berndporr/zetabot/hardware/cameraholder/README.md

# Camera holder

This is for a single camera glued on the LIDAR enclosure in the
middle of the robot.

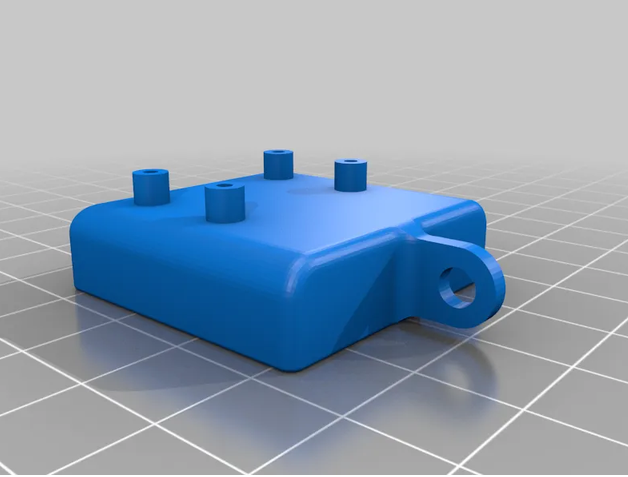
[picture p2: hardware/cameraholder/3dpic.png]


## Credit

https://www.printables.com/model/262546-pi-camera-wall-mount/files

https://www.printables.com/@Magnesium117_343395

License

Creative Commons License This work is licensed under a
Creative Commons (4.0 International License)
Attribution
