berndporr/zetabot/hardware/bom.pdf

ZetaBot

Id Designator | Footprint | Quantity
2 C1 | CP_Radial_D12.5mm_P5.00mm | 1
3 C2, C3, C4, C5, C6 C_Disc_D3.0mm_W2.0mm_P2.50mm | 5
4 D1 | LED_D5.0mm_Clear | 1
5 F1 | Fuseholder_Cylinder-5x20mm_Schurter_0031_8201_Horizontal_Open | 1
6 J1 | USB_C | 1
7 J2 | PinHeader_1x05_P2.54mm_Vertical | 1
8 J3 | PinHeader_1x03_P2.54mm_Vertical | 1
9 J4 | PinHeader_1x03_P2.54mm_Vertical | 1
10 R1 | R_Axial_DIN0207_L6.3mm_D2.5mm_P10.16mm_Horizontal | 1
11 SW1 | TE_4-1825136-5 | 1
12 U1 | RPLIDAR C1 | 1
13 U1 | RPI5 | 1
14 U2 | BUCK_CONV | 1
15 | Servo | 2
16 | Ball castor with 2-hole fastening | 1
17

Designation | Supplier and ref
2200uF/Electr | any
1uF/Tantalum | any
LED | any
Fuse | any
USB C PD Modulle
Conn_01x05 | any
MOTOR_L | any
MOTOR_R | any
330R | any
SW_SPDT | any
RPLIDAR C1
RPI5 | Raspberry
Buck Converter
Parallax Cont Rotat Servo | https://www.parallax.com/product/parallax-continuous-rotation-servo/
Any small ball castor | https://www.esska-tech.co.uk/shop/Ball-castors-with-2-hole-fastening-Load-capacity-25-to-55-kg--952914741000-25890

https://www.amazon.com/ACEIRMC-Trigger-Polling-Detector-Notebook/dp/B0BTHXKM91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

https://www.slamtec.com/en/c1

https://thepihut.com/products/20w-adjustable-dc-dc-buck-converter-with-digital-display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
