berndporr/zetabot/hardware/bom.ods

Id | Designator | Footprint | Quantity | Designation | Supplier and ref
2 | C1 | CP_Radial_D12.5mm_P5.00mm | 1 | 2200uF/Electr | any
3 | C2, C3, C4, C5, C6 | C_Disc_D3.0mm_W2.0mm_P2.50mm | 5 | 1uF/Tantalum | any
4 | D1 | LED_D5.0mm_Clear | 1 | LED | any
5 | F1 | Fuseholder_Cylinder-5x20mm_Schurter_0031_8201_Horizontal_Open | 1 | Fuse | any
6 | J1 | USB_C | 1 | USB C PD Modulle | https://www.amazon.com/ACEIRMC-Trigger-Polling-Detector-Notebook/dp/B0BTHXKM91
7 | J2 | PinHeader_1x05_P2.54mm_Vertical | 1 | Conn_01x05 | any
8 | J3 | PinHeader_1x03_P2.54mm_Vertical | 1 | MOTOR_L | any
9 | J4 | PinHeader_1x03_P2.54mm_Vertical | 1 | MOTOR_R | any
10 | R1 | R_Axial_DIN0207_L6.3mm_D2.5mm_P10.16mm_Horizontal | 1 | 330R | any
11 | SW1 | TE_4-1825136-5 | 1 | SW_SPDT | any
12 | U1 | RPLIDAR C1 | 1 | RPLIDAR C1 | https://www.slamtec.com/en/c1
13 | U1 | RPI5 | 1 | RPI5 | Raspberry
14 | U2 | BUCK_CONV | 1 | Buck Converter | https://thepihut.com/products/20w-adjustable-dc-dc-buck-converter-with-digital-display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
15 |  | Servo | 2 | Parallax Cont Rotat Servo | https://www.parallax.com/product/parallax-continuous-rotation-servo/
16 |  | Ball castor with 2-hole fastening | 1 | Any small ball castor | https://www.esska-tech.co.uk/shop/Ball-castors-with-2-hole-fastening-Load-capacity-25-to-55-kg--952914741000-25890
17
