berndporr/zetabot/hardware/batteryrest/batt.stl

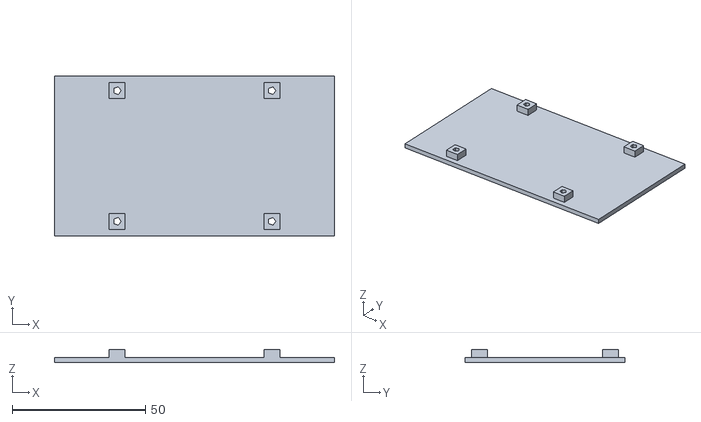
[picture p3: CAD file, 2026-08-22]
hardware/batteryrest/batt.stl
105.0 x 60.0 x 5.00
