berndporr/zetabot/hardware/camera/ov9281_innomaker_footprint.stl

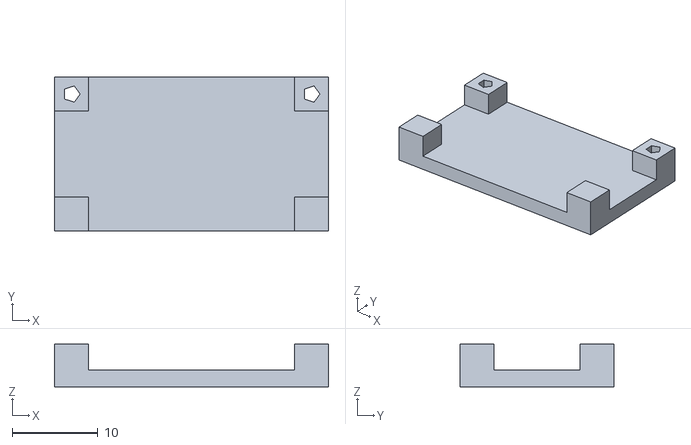
[picture p4: CAD file, 2026-10-07]
hardware/camera/ov9281_innomaker_footprint.stl
32.0 x 18.0 x 5.00
