berndporr/zetabot/hardware/cameraholder/cam_mnt_1.stl

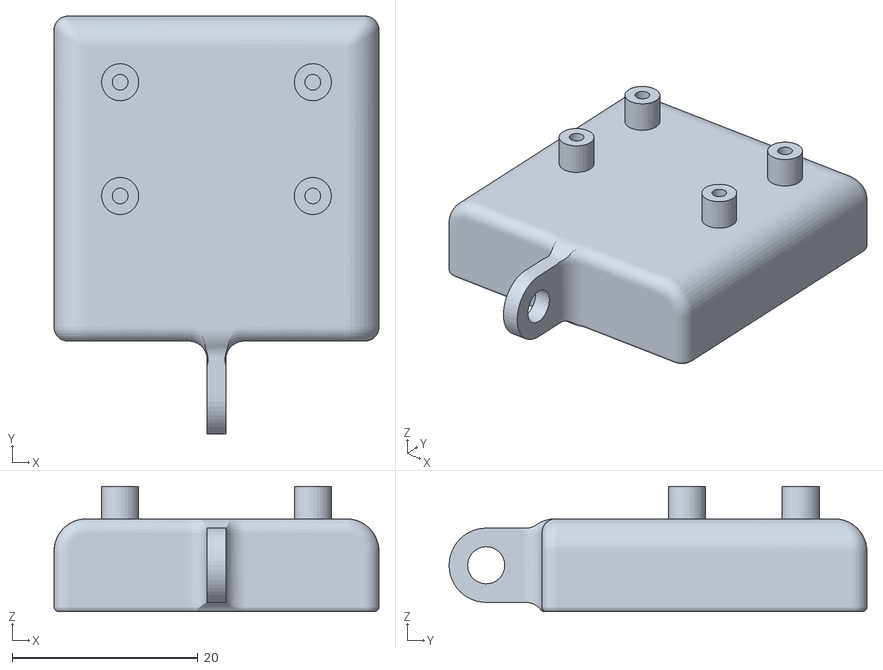
[picture p5: CAD file, 2026-08-06]
hardware/cameraholder/cam_mnt_1.stl
35.0 x 45.0 x 13.5
