berndporr/zetabot/hardware/camera/ov9281_picam_footprint.stl

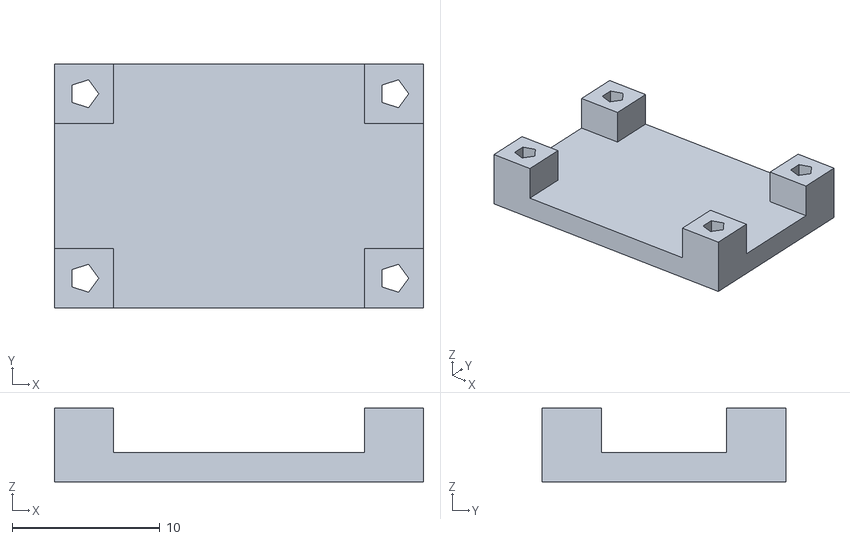
[picture p6: CAD file, 2026-08-23]
hardware/camera/ov9281_picam_footprint.stl
25.0 x 16.5 x 5.00
