berndporr/zetabot/(list of files, cad)

Other CAD files:
hardware/camera/ov9281_innomaker_footprint.scad
hardware/camera/picamera.scad
