berndporr/zetabot/schematic_files/gufiles/bcu.pdf

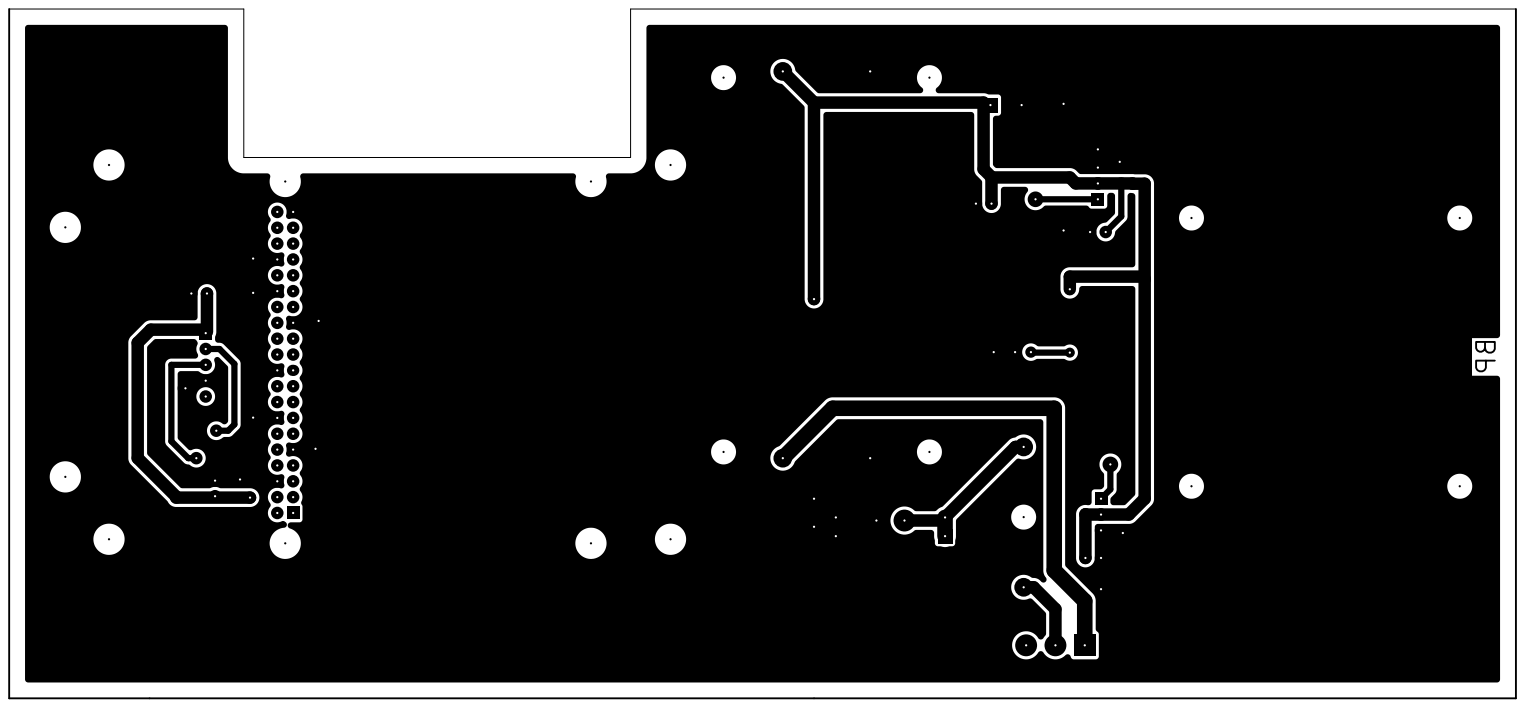
[picture p7: page 1]
