berndporr/zetabot/schematic_files/gufiles/fcu.pdf

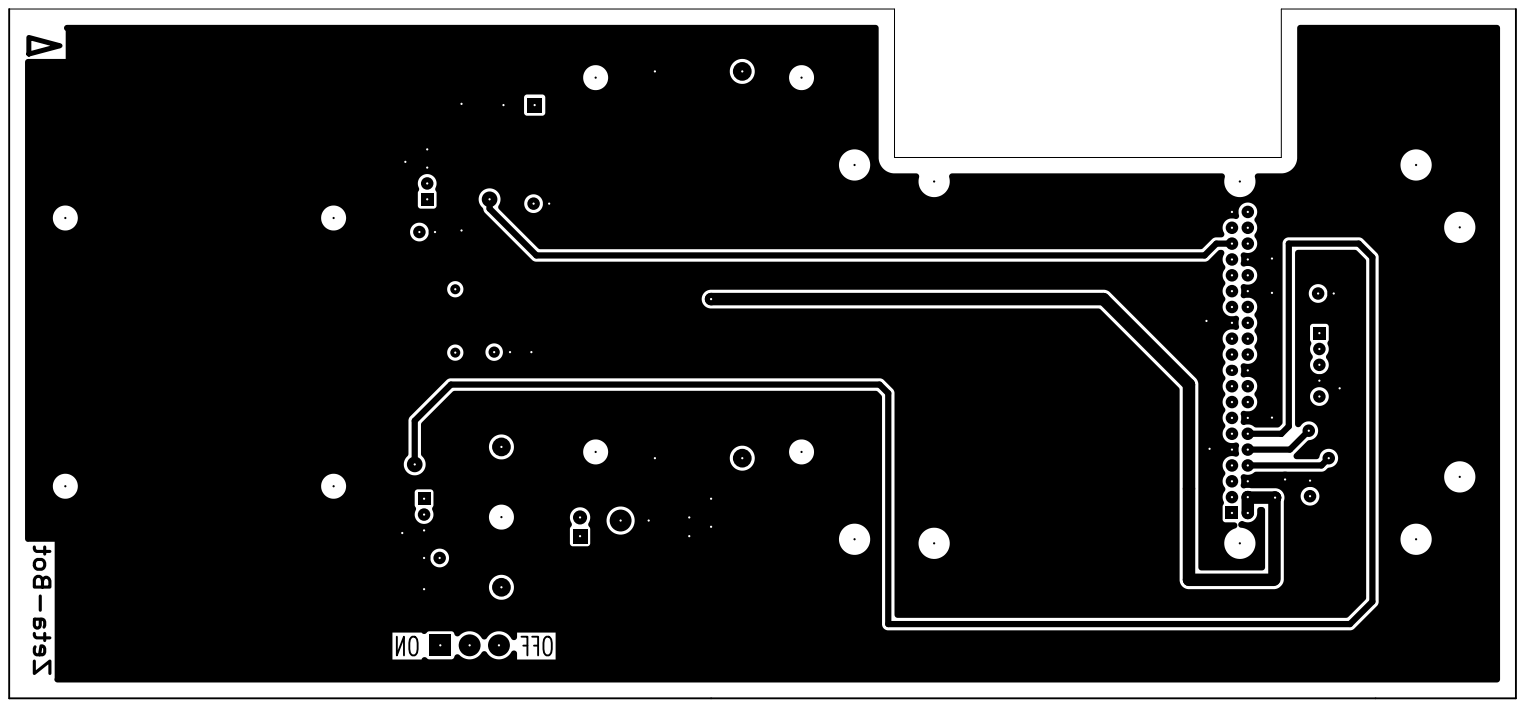
[picture p8: page 1]
