berndporr/zetabot/hardware/ZetaBot.kicad_pcb

## KiCad design hardware/ZetaBot.kicad_pcb (2026-10-21)

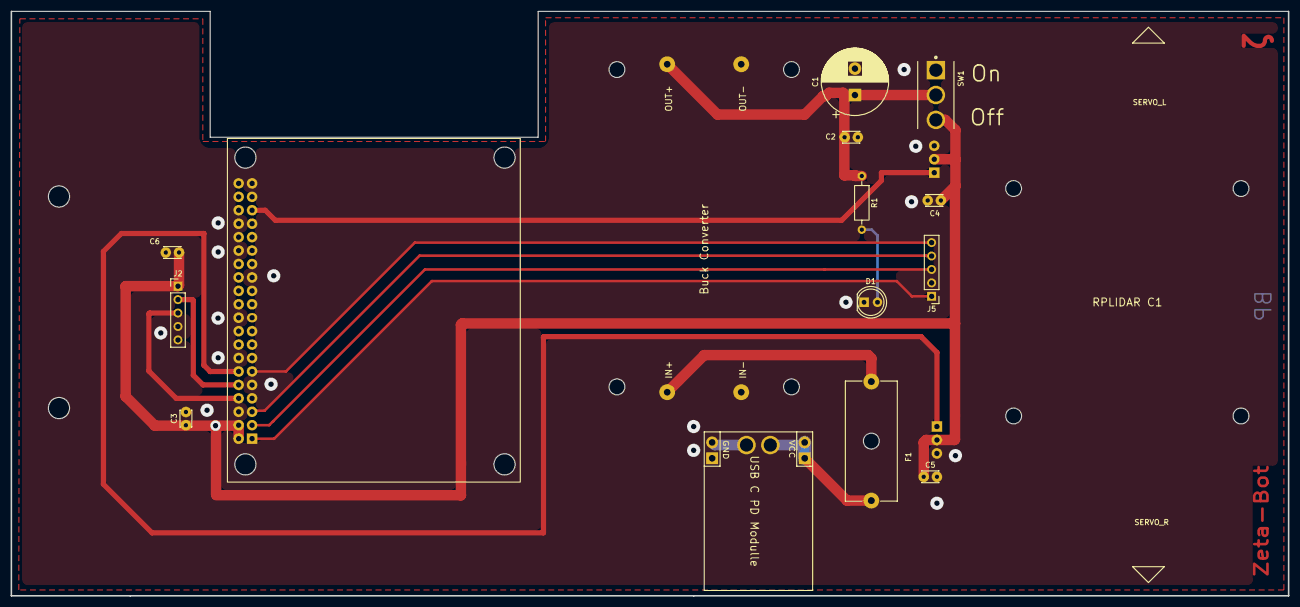
[picture p9: board ZetaBot.kicad_pcb from above]

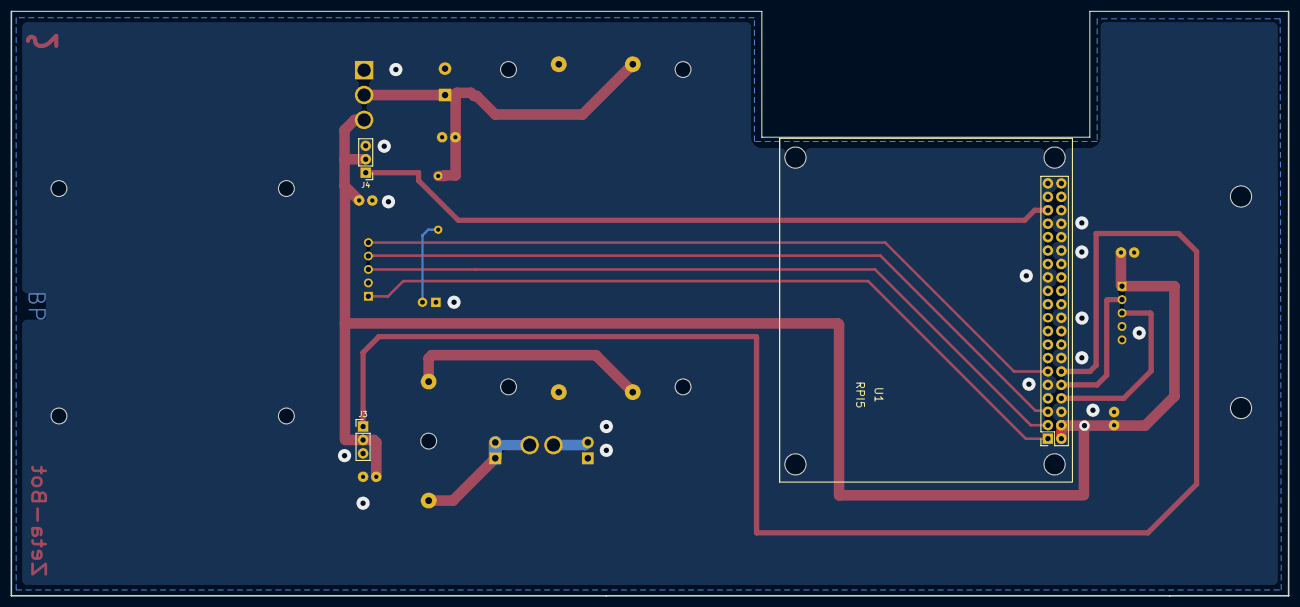
[picture p10: board ZetaBot.kicad_pcb from below]

Board: 2 copper layers, 241.5 x 110.5 mm, 18 parts (3 on the bottom side), 14 nets.

Parts:
C1: 2200uF; CP_Radial_D12.5mm_P5.00mm
C2, C3, C4, C5, C6: 1uF; C_Disc_D3.0mm_W2.0mm_P2.50mm
D1: LED; LED_D5.0mm_Clear
F1: Fuse; Fuseholder_Cylinder-5x20mm_Schurter_0031_8201_Horizontal_Op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
J1: USB C PD Modulle; USB_C
J2: Conn_01x05; PinHeader_1x05_P2.54mm_Vertical
J3: MOTOR_R; PinHeader_1x03_P2.54mm_Vertical
J4: MOTOR_L; PinHeader_1x03_P2.54mm_Vertical
J5: LSM6DSOX; PinHeader_1x05_P2.54mm_Vertical
R1: 330R; R_Axial_DIN0207_L6.3mm_D2.5mm_P10.16mm_Horizontal
SW1: SW_SPDT; TE_4-1825136-5
U1: RPLIDAR C1
U1#2: RPI5
U2: Buck Converter; BUCK_CONV

Connections:
+5V: C3.1, C4.1, C5.1, C6.1, J2.1, J3.2, J4.2, SW1.3 (C), U1#2.2 (5V1), U1#2.4 (5V2)
+9V: F1.1, U2.1 (IN+)
GND: C1.2, C2.2, C3.2, C4.2, C5.2, C6.2, D1.1 (K), J1.2 (GND), J1.4 (GND), J2.4, J3.3, J4.3, J5.2, U1#2.6 (GND1), U1#2.9 (GND8), U1#2.14 (GND2), U1#2.20 (GND3), U1#2.25 (GND7), U1#2.30 (GND4), U1#2.34 (GND5), U1#2.39 (GND6), U2.2 (IN-), U2.4 (OUT-)
LIDAR_RX: J2.3, U1#2.8 (GPIO14_UART/TX)
LIDAR_TX: J2.2, U1#2.10 (GPIO15_UART/RX)
unnamed: D1.2 (A), R1.2
unnamed: F1.2, J1.1 (VCC), J1.3 (VCC)
unnamed: J5.1, U1#2.1 (3.3V)
unnamed: J5.3, U1#2.3 (GPIO02_I2C1/SDA)
unnamed: J5.4, U1#2.5 (GPIO03_I2C1/SCL)
unnamed: J5.5, U1#2.11 (GPIO17)
unnamed: C1.1, C2.1, R1.1, SW1.2 (B), U2.3 (OUT+)
PWM_L: J4.1, U1#2.35 (GPIO19_PWM0/CHAN2)
PWM_R: J3.1, U1#2.12 (GPIO18_PWM0/CHAN2)
