berndporr/zetabot/(commit log)

2026-04-12 It's now the Zeta-bot
    [ZetaBot.kicad_pcb, ZetaBot.kicad_sch]
2026-04-12 Updated buck converter and re designed layout. Need to DRC.
    [ZetaBot.kicad_pcb]
2026-04-12 2nd revision. DRC passed.
    [ZetaBot.kicad_pcb, ZetaBot.kicad_sch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]
2026-04-13 Added two holes for the caster ball.
    [ZetaBot.kicad_pcb]
2026-04-14 Updated the masks with the two drill holes
2026-04-14 Updated drill and gerber
    [ZetaBot-B_Cu.gbl, ZetaBot-Edge_Cuts.gm1, ZetaBot-F_Cu.gtl, ZetaBot-NPTH.drl, ZetaBot-PTH.drl, ZetaBot-job.gbrjob]
2026-04-14 Added motor control
2026-04-14 On/Off was wrongly labelled
    [ZetaBot.kicad_pcb]
2026-04-15 Updated the nets of the motors (L-R) and the pin headers.
    [ZetaBot.kicad_pcb, ZetaBot.kicad_sch]
2026-04-15 Added basic info about the robot
    [deltabot.f3z]
2026-04-15 Added more info how to control the motors.
2026-04-26 Added stereo camera application
2026-04-26 Added info about the power bank.
2026-04-27 Wire diameter corrected
2026-04-29 swapped motors
2026-04-29 endless swapping and changed sprintf for l wheel
    [testIO.cpp]
2026-07-22 Added header for Gyro and moved switch to post buck converter.
    [ZetaBot.kicad_pcb, ZetaBot.kicad_sch]
2026-07-23 Moved switch out of the way of the servo
    [ZetaBot.kicad_pcb]
2026-07-23 Now 99% of all tracks are on the top layer assuming we'll have vias!
    [ZetaBot.kicad_pcb]
2026-08-06 Added the camera holder
    [cam_mnt_1.stl]
2026-08-21 Added initial version of the battery rest
    [batt.scad]
2026-08-21 Fixed holes
    [batt.scad]
2026-08-22 Added stl for 3D printing.
    [batt.scad, batt.stl]
2026-08-22 openscad uses radius as default so hole too large!
    [batt.scad, batt.stl]
2026-08-22 Made it countersunk gaining 1mm for the nut!
    [batt.scad, batt.stl]
2026-08-23 Added picamera mounting plate
    [picamera.scad, picamera.stl]
2026-10-07 New camera
    [OV9281.scad, OV9281.stl, picamera.stl]
2026-10-07 Made the mounting plate bigger
    [OV9281.scad, OV9281.stl]
2026-10-08 Updated the camera
2026-10-09 Added the gyro
2026-10-09 Added a new photo with the global shutter camera
2026-10-09 Added NVME board
2026-10-20 Updated the export settings for PCBWay
2026-10-21 Updated the bom
2026-10-21 2nd BOM update
2026-11-10 Added ov9281 picam style footprint.
